kasbah/avr-capacitive-touch/pcb/qTouchTest2.kicad_pcb

## KiCad design pcb/qTouchTest2.kicad_pcb (2013-03-29)

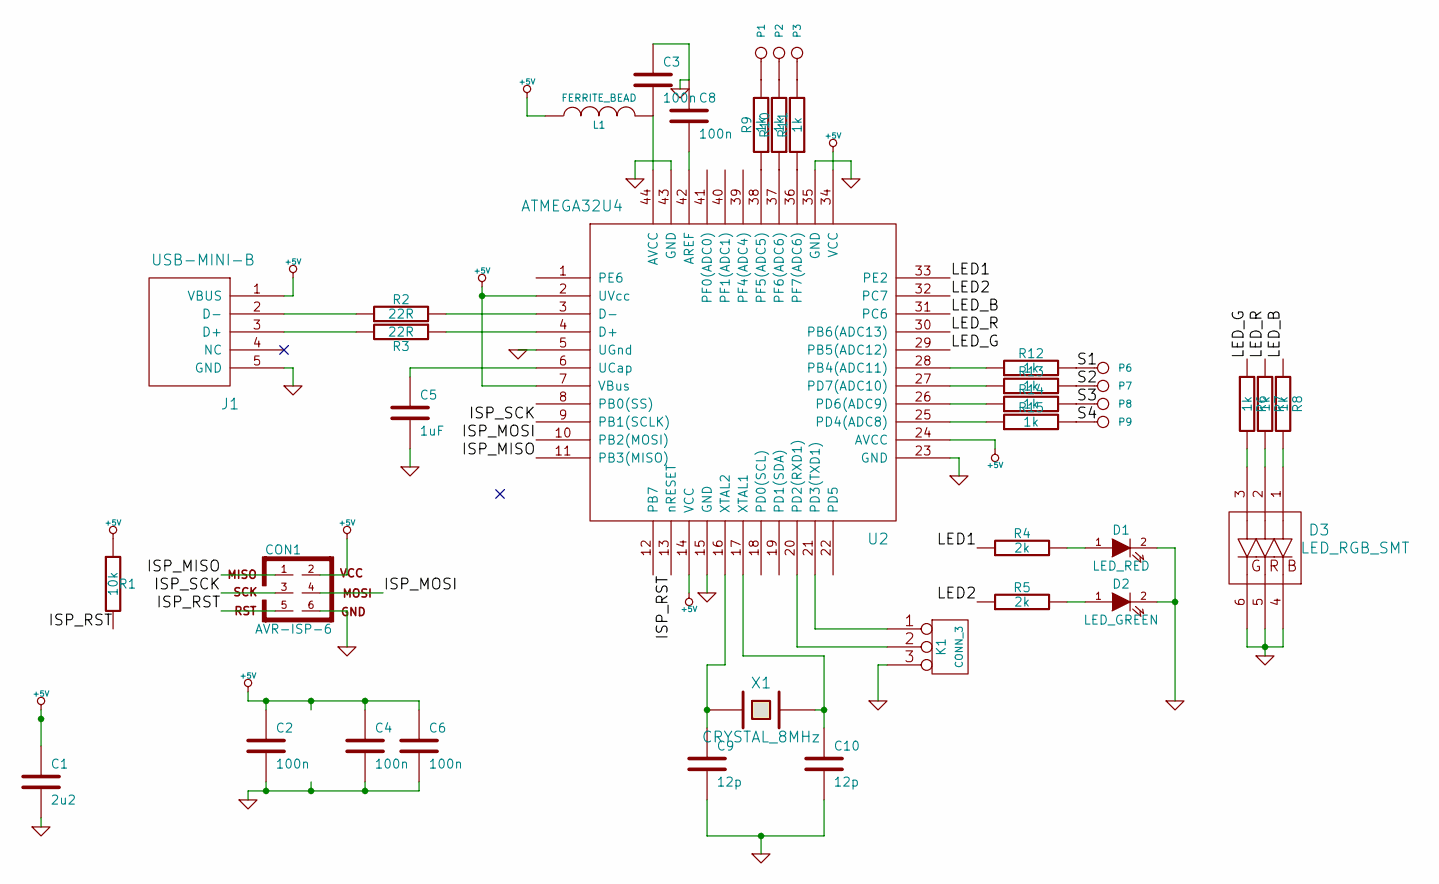
[picture p1: schematic qTouchTest2.sch]

Parts:
C1: 2u2
C2, C3, C4, C6, C8: 100n
C5: 1uF
C9, C10: 12p
CON1: AVR-ISP-6
D1: LED_RED
D2: LED_GREEN
D3: LED_RGB_SMT
J1: USB-MINI-B
K1: CONN_3
L1: FERRITE_BEAD
P1, P2, P3, P6, P7, P8, P9: CONN_1
R1: 10k
R2, R3: 22R
R4, R5: 2k
R6, R7, R8, R9, R10, R11, R12, R13, R14, R15: 1k
U2: ATMEGA32U4
X1: CRYSTAL_8MHz

Connections:
+5V: C1.1, C2.1, C4.1, C6.1, CON1.2, J1.1 (VBUS), L1.1, R1.1, U2.2 (UVcc), U2.7 (VBus), U2.14 (VCC), U2.24 (AVCC), U2.34 (VCC)
/ISP_MISO: CON1.1, U2.11 (PB3(MISO))
/ISP_MOSI: CON1.4, U2.10 (PB2(MOSI))
/ISP_RST: CON1.5, R1.2, U2.13 (nRESET)
/ISP_SCK: CON1.3, U2.9 (PB1(SCLK))
/LED1: R4.1, U2.33 (PE2)
/LED2: R5.1, U2.32 (PC7)
/LED_B: R8.1, U2.31 (PC6)
/LED_G: R6.1, U2.29 (PB5(ADC12))
/LED_R: R7.1, U2.30 (PB6(ADC13))
/S1: P6.1, R12.2
/S2: P7.1, R13.2
/S3: P8.1, R14.2
/S4: P9.1, R15.2
GND: C1.2, C2.2, C3.1, C4.2, C5.2, C6.2, C8.1, C9.2, C10.2, CON1.6, D1.2 (K), D2.2 (K), D3.4, D3.5, D3.6, J1.5 (GND), K1.3, U2.5 (UGnd), U2.15 (GND), U2.23 (GND), U2.35 (GND), U2.43 (GND)
unnamed: C10.1, U2.17 (XTAL1), X1.2
unnamed: C9.1, U2.16 (XTAL2), X1.1
unnamed: D3.2, R7.2
unnamed: R15.1, U2.25 (PD4(ADC8))
unnamed: R9.1, U2.38 (PF5(ADC5))
unnamed: R10.1, U2.37 (PF6(ADC6))
unnamed: R13.1, U2.27 (PD7(ADC10))
unnamed: R11.1, U2.36 (PF7(ADC6))
unnamed: R14.1, U2.26 (PD6(ADC9))
unnamed: C3.2, L1.2, U2.44 (AVCC)
unnamed: C8.2, U2.42 (AREF)
unnamed: C5.1, U2.6 (UCap)
unnamed: P3.1, R11.2
unnamed: P2.1, R10.2
unnamed: P1.1, R9.2
unnamed: D1.1 (A), R4.2
unnamed: D2.1 (A), R5.2
unnamed: K1.1, U2.21 (PD3(TXD1))
unnamed: K1.2 (PM), U2.20 (PD2(RXD1))
unnamed: R2.2, U2.3 (D-)
unnamed: J1.2 (D-), R2.1
unnamed: J1.3 (D+), R3.2
unnamed: R3.1, U2.4 (D+)
unnamed: R12.1, U2.28 (PB4(ADC11))
unnamed: D3.3, R6.2
unnamed: D3.1, R8.2

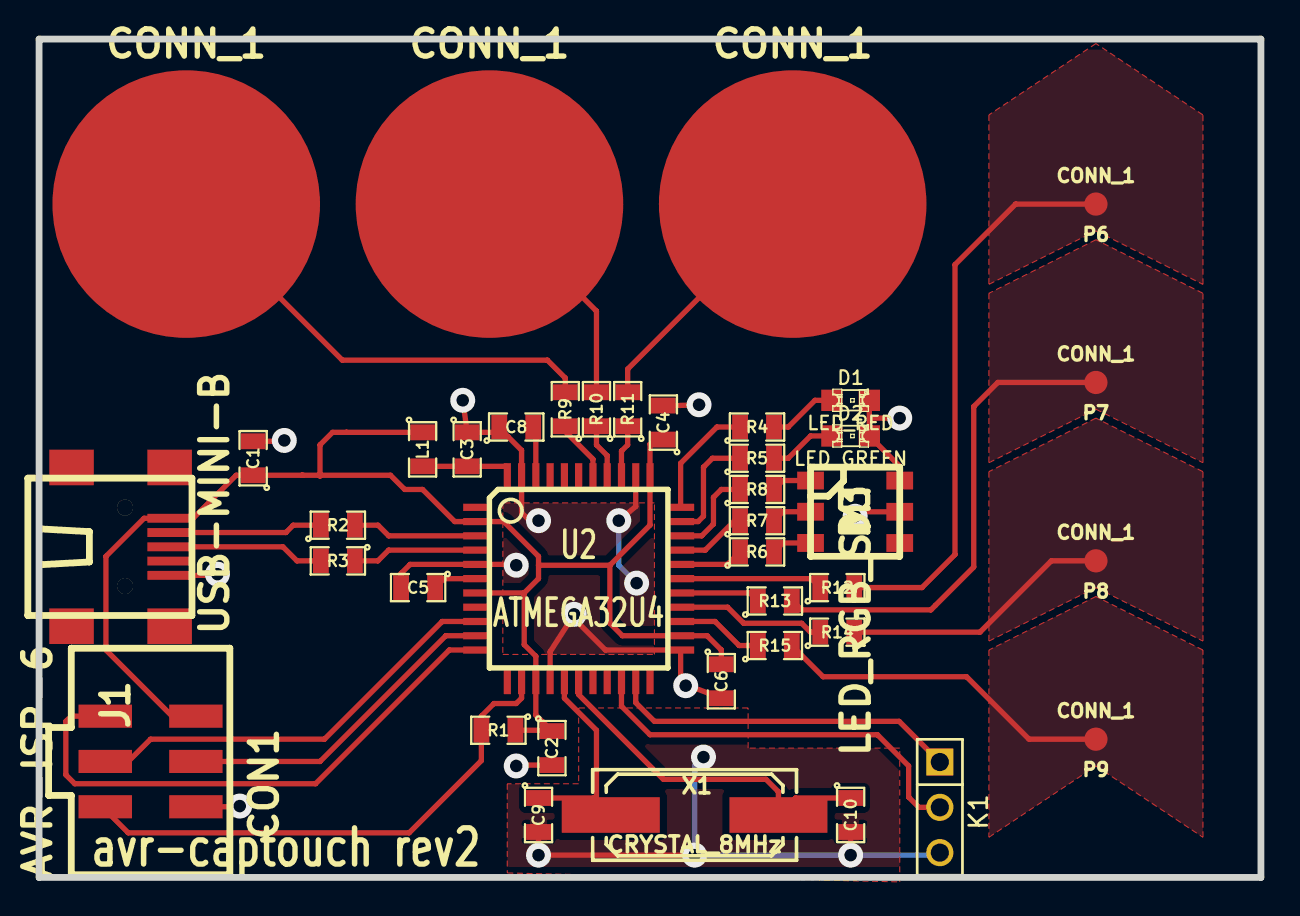
[picture p2: board qTouchTest2.kicad_pcb from above]

Board: 2 copper layers, 68.5 x 47.0 mm, 40 parts (0 on the bottom side), 41 nets.
