kasbah/avr-capacitive-touch/(commit log)

2013-03-28 propagating C5 value change to brd and cmp
    [qTouchTest2.brd]
2013-03-28 updating to kicad-20130226-stable
    [qTouchTest2.brd, qTouchTest2.kicad_pcb, qTouchTest2.sch]
2013-03-28 adding ferrite bead and crystal info
    [qTouchTest2.kicad_pcb, qTouchTest2.sch]
2013-03-28 adding colour info to LEDs
    [qTouchTest2.kicad_pcb, qTouchTest2.sch]
2013-03-28 adding BOM csv
    [qTouchTest2_BOM.csv]
2013-03-28 adding rev2 text, one trace thickness modified
    track to P6 thickness doubled as sensitivity was
    below others
    [qTouchTest2.kicad_pcb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]
2013-03-28 cleaning up output files
    [qTouchTest2-Back.gbl, qTouchTest2-Front.gtl, qTouchTest2-PCB_Edges.gbr, qTouchTest2.drl]
2013-03-28 fixing solder resist for cap touch pads
    [qTouchTest2-B_SilkS.gbo, qTouchTest2-Back.gbl, qTouchTest2-Edge_Cuts.gbr, qTouchTest2-F_Paste.gtp, qTouchTest2-F_SilkS.gto, qTouchTest2-Front.gtl, qTouchTest2-PCB_Edges.gbr, qTouchTest2.drl]
2013-03-29 reducing width of trace, moving ground plane
    [qTouchTest2.kicad_pcb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]
